benediktibk/home-automation/hardware/temperature-sensor/temperature-sensor.kicad_pcb

## KiCad design hardware/temperature-sensor/temperature-sensor.kicad_pcb (2025-07-15)

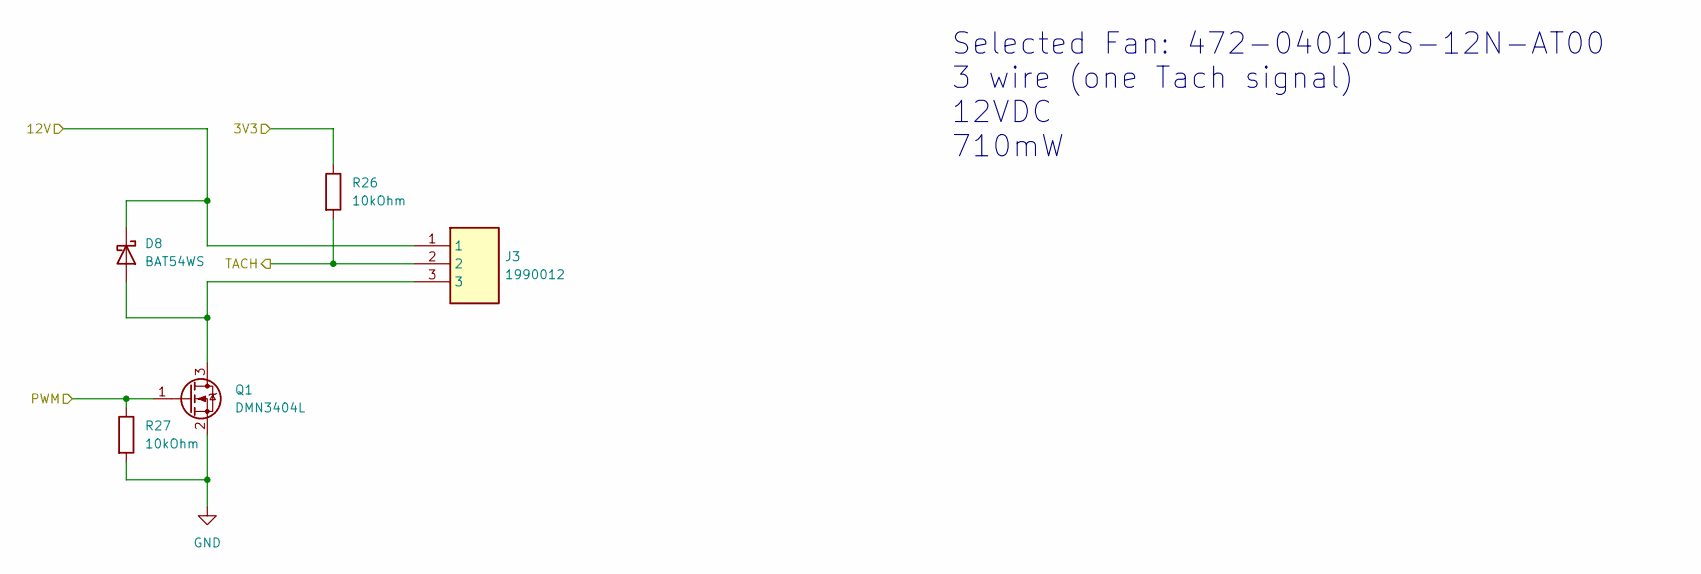
[picture p1: schematic fan.kicad_sch]

Parts:
D8: BAT54WS; D_SOD-323; Mouser Part Number 637-BAT54WS
J3: 1990012; Mouser Part Number 651-1990012
Q1: DMN3404L; SOT-23; Mouser Part Number 621-DMN3404L-7
R26, R27: 10kOhm; R_0603_1608Metric_Pad0.98x0.95mm_HandSolder; Mouser Part Number 652-CR0603FX-1002ELF

Connections:
/3V3: R26.1; also elsewhere on the board
/12V: D8.1 (K), J3.1; also elsewhere on the board
/Fan/PWM: Q1.1 (G), R27.1; also elsewhere on the board
/Fan/TACH: J3.2, R26.2; also elsewhere on the board
GND: Q1.2 (S), R27.2; also elsewhere on the board
unnamed: D8.2 (A), J3.3, Q1.3 (D)

Notes on the sheet:
Selected Fan: 472-04010SS-12N-AT00 3 wire (one Tach signal) 12VDC 710mW

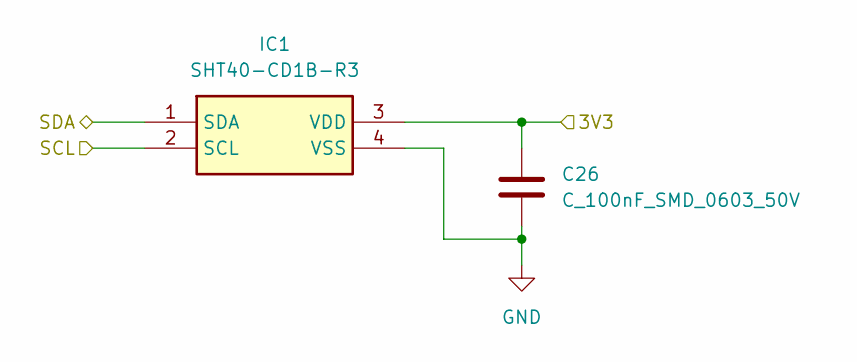
[picture p2: schematic measurement.kicad_sch]

Parts:
C26: C_100nF_SMD_0603_50V; C_0603_1608Metric_Pad1.08x0.95mm_HandSolder; Mouser Part Number 581-KGM15BR71H104KM
IC1: SHT40-CD1B-R3; SHT40CD1BR3; Mouser Part Number 403-SHT40-CD1B-R3

Connections:
/3V3: C26.1, IC1.3 (VDD); also elsewhere on the board
/MCU/SCL: IC1.2 (SCL); also elsewhere on the board
/MCU/SDA: IC1.1 (SDA); also elsewhere on the board
GND: C26.2, IC1.4 (VSS); also elsewhere on the board

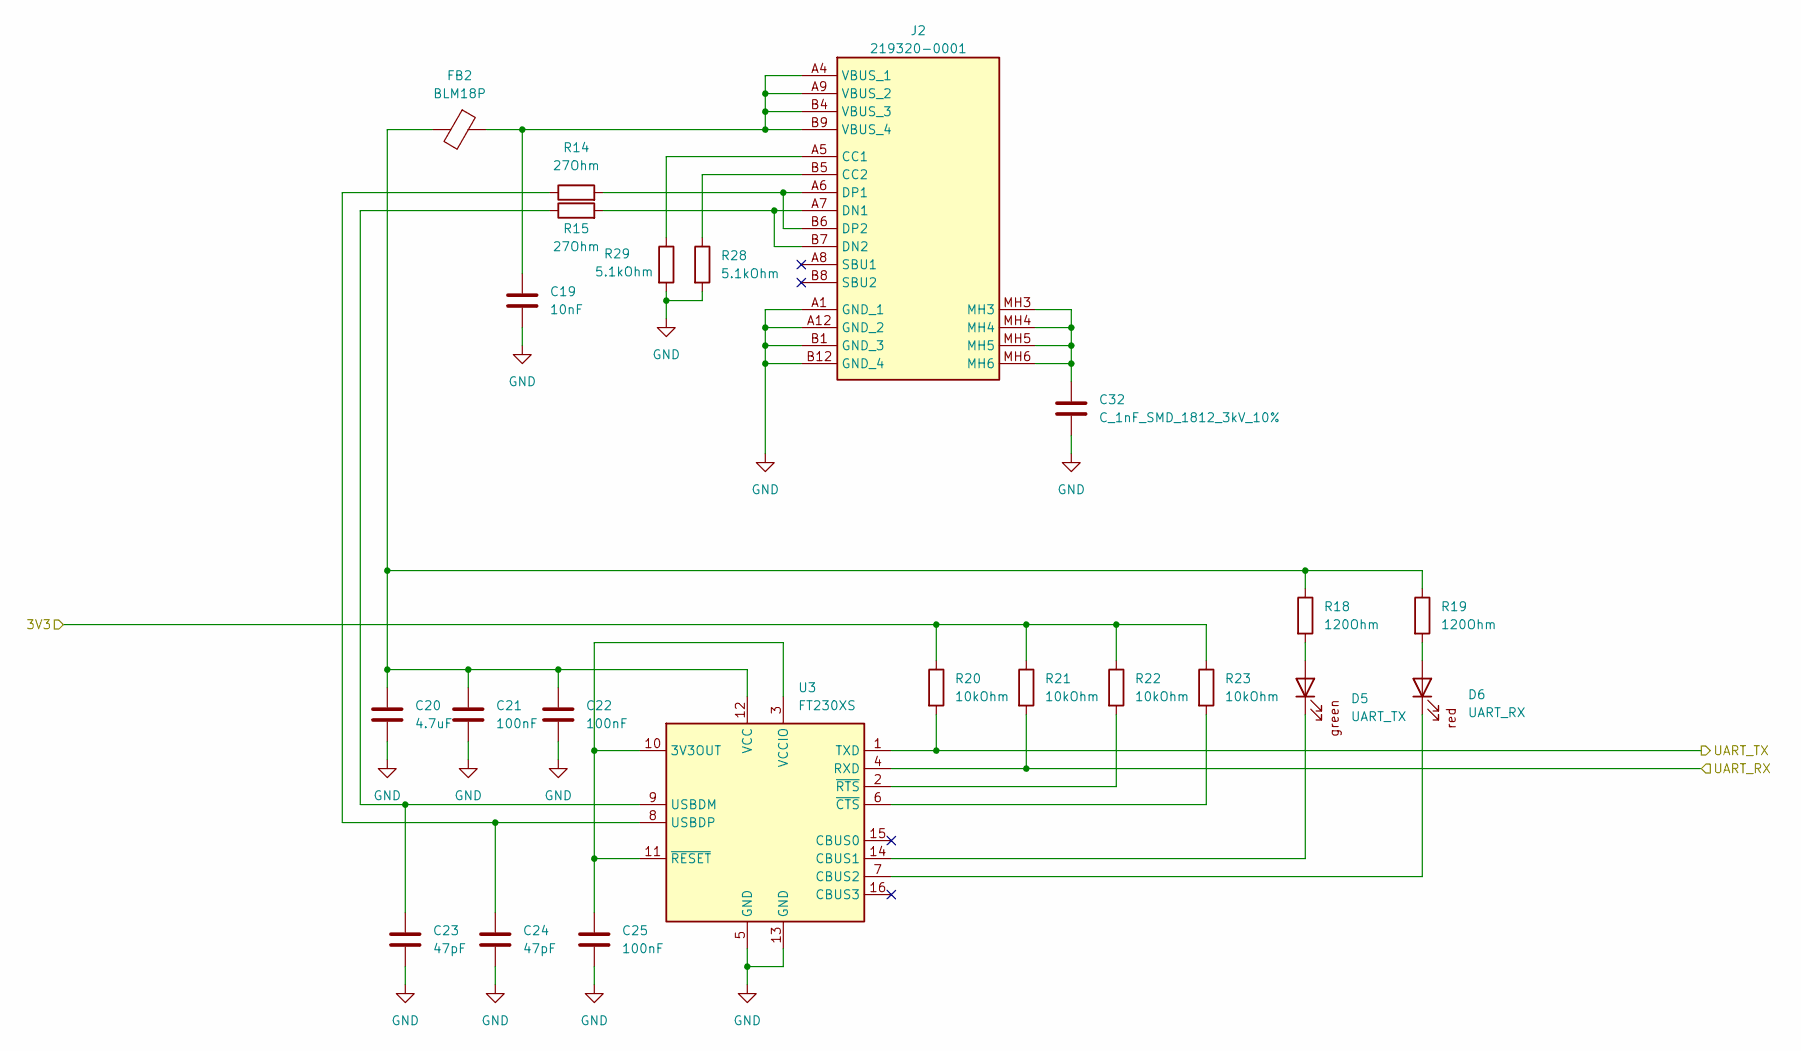
[picture p3: schematic usb.kicad_sch]

Parts:
C19: 10nF; C_0603_1608Metric_Pad1.08x0.95mm_HandSolder; Mouser Part Number 80-C0603C103M5R3121
C20: 4.7uF; C_0805_2012Metric_Pad1.18x1.45mm_HandSolder; Mouser Part Number 187-CL21A475KBQNNNE
C21, C22, C25: 100nF; C_0603_1608Metric_Pad1.08x0.95mm_HandSolder; Mouser Part Number 581-KGM15BR71H104KM
C23, C24: 47pF; C_0603_1608Metric_Pad1.08x0.95mm_HandSolder; Mouser Part Number 791-0603N470J101CT
C32: C_1nF_SMD_1812_3kV_10%; C_0603_1608Metric_Pad1.08x0.95mm_HandSolder; Mouser Part Number 791-1812B102K302CT
D5: UART_TX; D_0603_1608Metric_Pad1.05x0.95mm_HandSolder; Mouser Part Number 604-AP1608SGC
D6: UART_RX; D_0603_1608Metric_Pad1.05x0.95mm_HandSolder; Mouser Part Number 859-LTST-C190KDKT10A
FB2: BLM18P; R_0603_1608Metric_Pad0.98x0.95mm_HandSolder; Mouser Part Number 81-BLM11P300S
J2: 219320-0001; 2193200001; Mouser Part Number 538-219320-0001
R14, R15: 27Ohm; R_0603_1608Metric_Pad0.98x0.95mm_HandSolder; Mouser Part Number 603-RC0603FR-0727RL
R18, R19: 120Ohm; R_0603_1608Metric_Pad0.98x0.95mm_HandSolder; Mouser Part Number 603-RC0603FR-07120RL
R20, R21, R22, R23: 10kOhm; R_0603_1608Metric_Pad0.98x0.95mm_HandSolder; Mouser Part Number 652-CR0603FX-1002ELF
R28, R29: 5.1kOhm; R_0603_1608Metric_Pad0.98x0.95mm_HandSolder; Mouser Part Number 303-0603SAF5101T5E
U3: FT230XS; SSOP-16_3.9x4.9mm_P0.635mm; Mouser Part Number 895-FT230XS-R

Connections:
/3V3: R20.1, R21.1, R22.1, R23.1; also elsewhere on the board
/MCU/UART_RX: R20.2, U3.1 (TXD); also elsewhere on the board
/MCU/UART_TX: R21.2, U3.4 (RXD); also elsewhere on the board
GND: C19.2, C20.2, C21.2, C22.2, C23.2, C24.2, C25.2, C32.2, J2.A1 (GND_1), J2.A12 (GND_2), J2.B1 (GND_3), J2.B12 (GND_4), R28.2, R29.2, U3.5 (GND), U3.13 (GND); also elsewhere on the board
unnamed: C32.1, J2.MH3, J2.MH4, J2.MH5, J2.MH6
unnamed: D5.2 (A), R18.2
unnamed: D5.1 (K), U3.14 (CBUS1)
unnamed: D6.2 (A), R19.2
unnamed: D6.1 (K), U3.7 (CBUS2)
unnamed: J2.A5 (CC1), R29.1
unnamed: J2.B5 (CC2), R28.1
unnamed: J2.A7 (DN1), J2.B7 (DN2), R15.2
unnamed: J2.A6 (DP1), J2.B6 (DP2), R14.2
unnamed: C19.1, FB2.1, J2.A4 (VBUS_1), J2.A9 (VBUS_2), J2.B4 (VBUS_3), J2.B9 (VBUS_4)
unnamed: C25.1, U3.3 (VCCIO), U3.10 (3V3OUT), U3.11 (~RESET)
unnamed: C23.1, R15.1, U3.9 (USBDM)
unnamed: C24.1, R14.1, U3.8 (USBDP)
unnamed: C20.1, C21.1, C22.1, FB2.2, R18.1, R19.1, U3.12 (VCC)
unnamed: R23.2, U3.6 (~CTS)
unnamed: R22.2, U3.2 (~RTS)

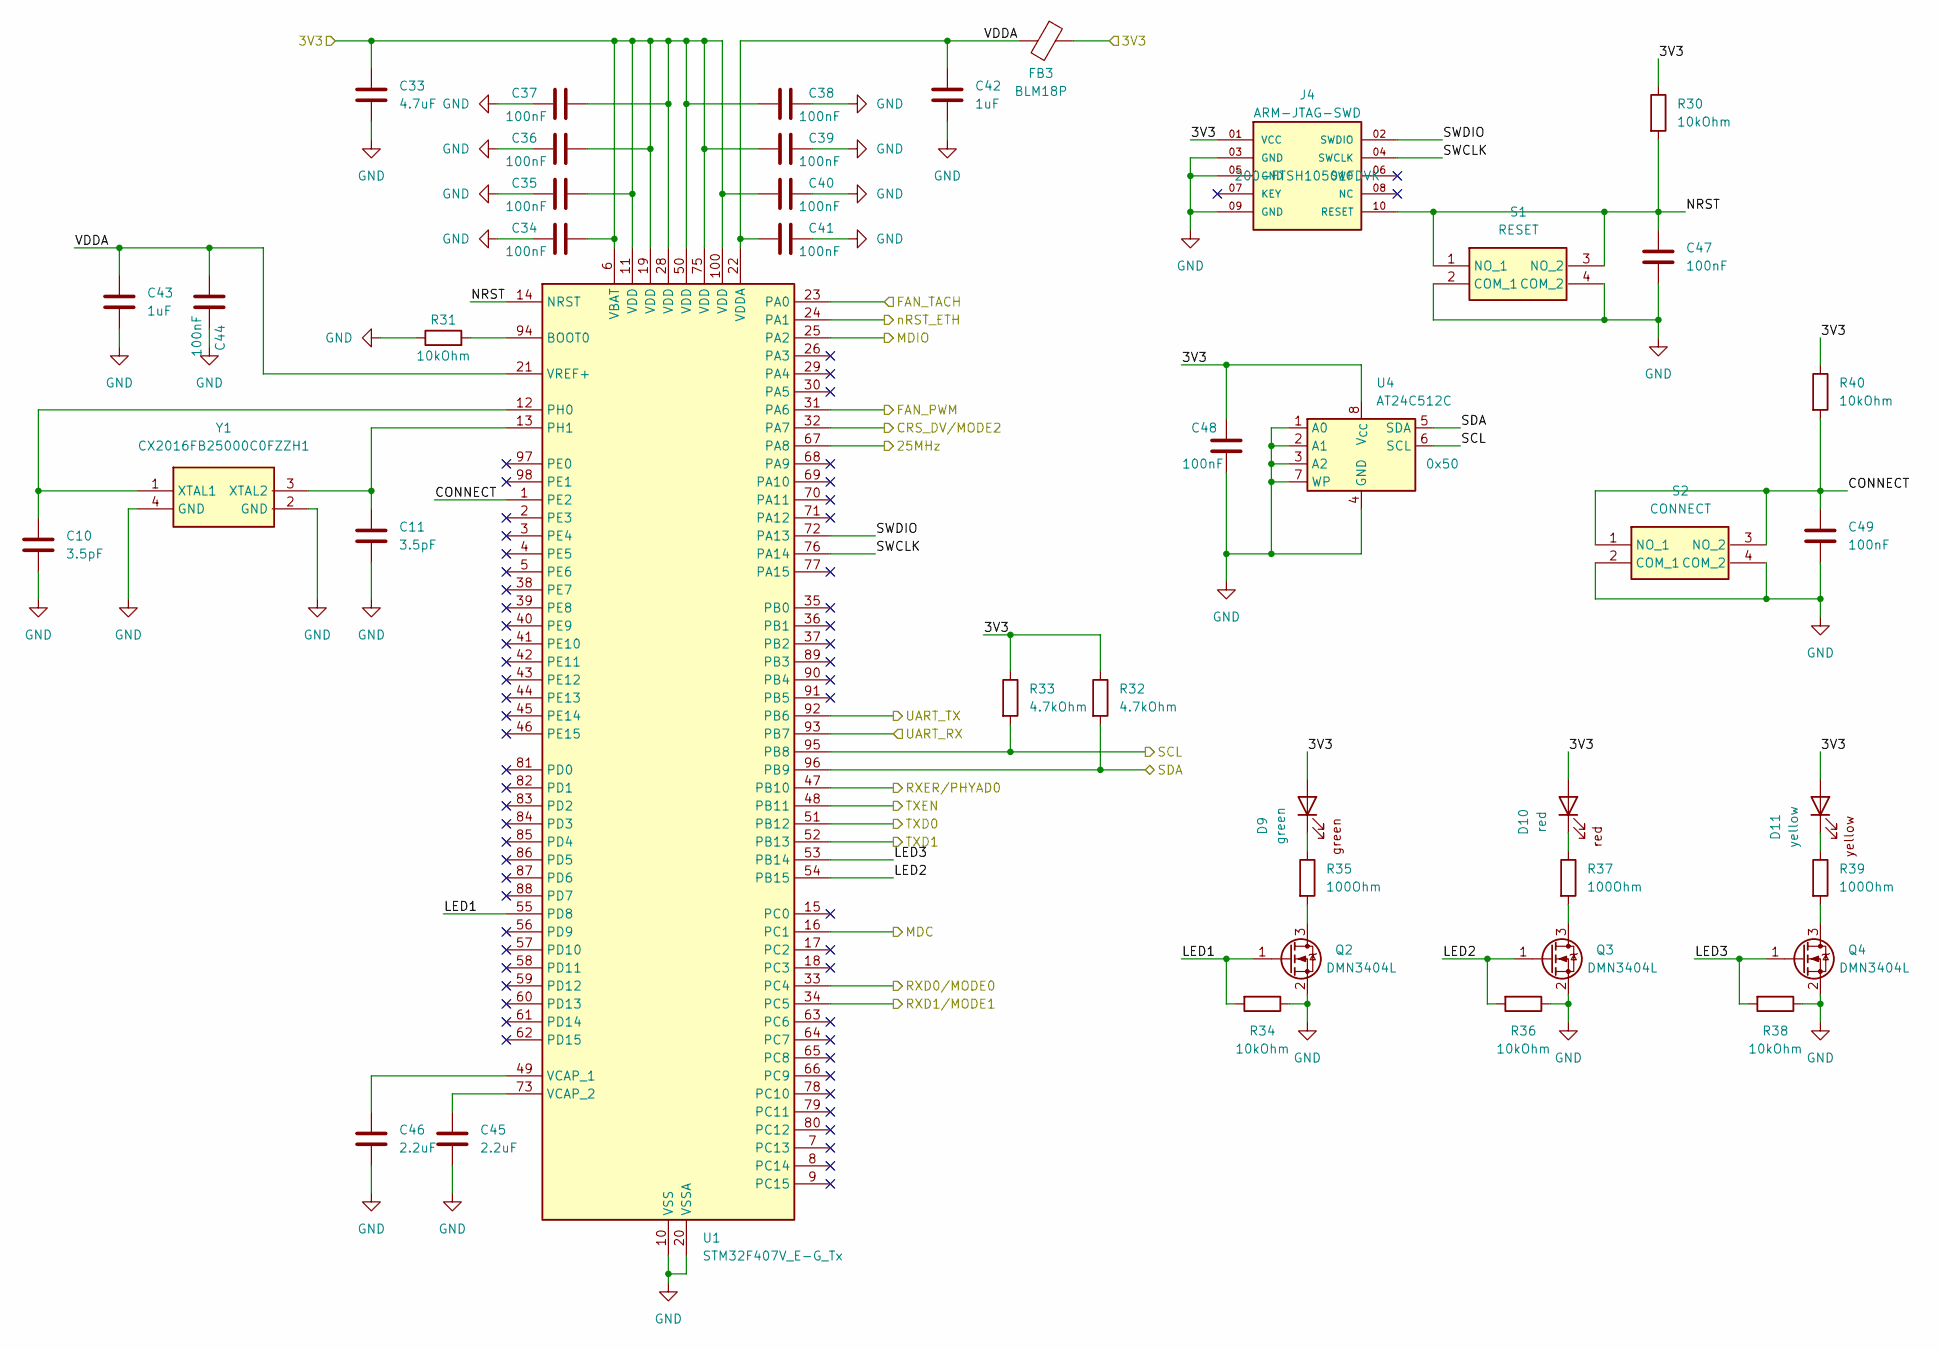
[picture p4: schematic MCU.kicad_sch]

Parts:
C10, C11: 3.5pF; C_0603_1608Metric_Pad1.08x0.95mm_HandSolder; Mouser Part Number 80-CBR06C359B5GAC
C33: 4.7uF; C_0805_2012Metric_Pad1.18x1.45mm_HandSolder; Mouser Part Number 187-CL21A475KBQNNNE
C34, C35, C36, C37, C38, C39, C40, C41, C44, C47, C48, C49: 100nF; C_0603_1608Metric_Pad1.08x0.95mm_HandSolder; Mouser Part Number 581-KGM15BR71H104KM
C42, C43: 1uF; C_0603_1608Metric_Pad1.08x0.95mm_HandSolder; Mouser Part Number 963-UMK107BJ105KA-T
C45, C46: 2.2uF; C_0603_1608Metric_Pad1.08x0.95mm_HandSolder; Mouser Part Number 187-CL10A225KP8NNND
D9: green; D_0603_1608Metric_Pad1.05x0.95mm_HandSolder; Mouser Part Number 604-AP1608SGC
D10: red; D_0603_1608Metric_Pad1.05x0.95mm_HandSolder; Mouser Part Number 859-LTST-C190KDKT10A
D11: yellow; D_0603_1608Metric_Pad1.05x0.95mm_HandSolder; Mouser Part Number 604-APG1608SYKC/T
FB3: BLM18P; R_0603_1608Metric_Pad0.98x0.95mm_HandSolder; Mouser Part Number 81-BLM11P300S
J4: ARM-JTAG-SWD; SAMTEC_FTSH-105-01-F-DV-P-TR; Mouser Part Number 200-FTSH10501FDVK
Q2, Q3, Q4: DMN3404L; SOT-23; Mouser Part Number 621-DMN3404L-7
R30, R31, R34, R36, R38, R40: 10kOhm; R_0603_1608Metric_Pad0.98x0.95mm_HandSolder; Mouser Part Number 652-CR0603FX-1002ELF
R32, R33: 4.7kOhm; R_0603_1608Metric_Pad0.98x0.95mm_HandSolder; Mouser Part Number 652-CR0603FX-4701ELF
R35, R37, R39: 100Ohm; R_0603_1608Metric_Pad0.98x0.95mm_HandSolder; Mouser Part Number 279-CRGH0603F100R
S1: RESET; TS046673BK100SMT; Mouser Part Number 179-TS046673BK100SMT
S2: CONNECT; TS046673BK100SMT; Mouser Part Number 179-TS046673BK100SMT
U1: STM32F407V_E-G_Tx; LQFP-100_14x14mm_P0.5mm; Mouser Part Number 511-STM32F407VGT6
U4: AT24C512C; SOIC127P600X175-8N; Mouser Part Number 556-AT24C512C-SSHM-T
Y1: CX2016FB25000C0FZZH1; Mouser Part Number 581-CX2016FB25C0FZZH

Connections:
/3V3: C33.1, C34.1, C35.1, C36.1, C37.1, C38.1, C39.1, C40.1, C48.1, D9.2 (A), D10.2 (A), D11.2 (A), FB3.1, J4.01 (VCC), R30.1, R32.1, R33.1, R40.1, U1.6 (VBAT), U1.11 (VDD), U1.19 (VDD), U1.28 (VDD), U1.50 (VDD), U1.75 (VDD), U1.100 (VDD), U4.8 (V_{CC}); also elsewhere on the board
/Ethernet/25MHz: U1.67 (PA8); also elsewhere on the board
/Ethernet/CRS_DV/MODE2: U1.32 (PA7); also elsewhere on the board
/Ethernet/MDC: U1.16 (PC1); also elsewhere on the board
/Ethernet/MDIO: U1.25 (PA2); also elsewhere on the board
/Ethernet/RXD0/MODE0: U1.33 (PC4); also elsewhere on the board
/Ethernet/RXD1/MODE1: U1.34 (PC5); also elsewhere on the board
/Ethernet/RXER/PHYAD0: U1.47 (PB10); also elsewhere on the board
/Ethernet/TXD0: U1.51 (PB12); also elsewhere on the board
/Ethernet/TXD1: U1.52 (PB13); also elsewhere on the board
/Ethernet/TXEN: U1.48 (PB11); also elsewhere on the board
/Ethernet/nRST: U1.24 (PA1); also elsewhere on the board
/Fan/PWM: U1.31 (PA6); also elsewhere on the board
/Fan/TACH: U1.23 (PA0); also elsewhere on the board
/MCU/CONNECT: C49.1, R40.2, S2.1 (NO_1), S2.3 (NO_2), U1.1 (PE2)
/MCU/LED1: Q2.1 (G), R34.2, U1.55 (PD8)
/MCU/LED2: Q3.1 (G), R36.2, U1.54 (PB15)
/MCU/LED3: Q4.1 (G), R38.2, U1.53 (PB14)
/MCU/NRST: C47.1, J4.10 (RESET), R30.2, S1.1 (NO_1), S1.3 (NO_2), U1.14 (NRST)
/MCU/SCL: R33.2, U1.95 (PB8), U4.6 (SCL); also elsewhere on the board
/MCU/SDA: R32.2, U1.96 (PB9), U4.5 (SDA); also elsewhere on the board
/MCU/SWCLK: J4.04 (SWCLK), U1.76 (PA14)
/MCU/SWDIO: J4.02 (SWDIO), U1.72 (PA13)
/MCU/UART_RX: U1.93 (PB7); also elsewhere on the board
/MCU/UART_TX: U1.92 (PB6); also elsewhere on the board
/MCU/VDDA: C41.1, C42.1, C43.1, C44.1, FB3.2, U1.21 (VREF+), U1.22 (VDDA)
GND: C10.2, C11.2, C33.2, C34.2, C35.2, C36.2, C37.2, C38.2, C39.2, C40.2, C41.2, C42.2, C43.2, C44.2, C45.2, C46.2, C47.2, C48.2, C49.2, J4.03 (GND), J4.05 (GND), J4.09 (GND), Q2.2 (S), Q3.2 (S), Q4.2 (S), R31.1, R34.1, R36.1, R38.1, S1.2 (COM_1), S1.4 (COM_2), S2.2 (COM_1), S2.4 (COM_2), U1.10 (VSS), U1.20 (VSSA), U1.27 (VSS), U1.74 (VSS), U1.99 (VSS), U4.1 (A0), U4.2 (A1), U4.3 (A2), U4.4 (GND), U4.7 (WP), Y1.2 (GND), Y1.4 (GND); also elsewhere on the board
unnamed: D9.1 (K), R35.1
unnamed: D10.1 (K), R37.1
unnamed: D11.1 (K), R39.1
unnamed: Q2.3 (D), R35.2
unnamed: Q3.3 (D), R37.2
unnamed: Q4.3 (D), R39.2
unnamed: R31.2, U1.94 (BOOT0)
unnamed: C10.1, U1.12 (PH0), Y1.1 (XTAL1)
unnamed: C11.1, U1.13 (PH1), Y1.3 (XTAL2)
unnamed: C46.1, U1.49 (VCAP_1)
unnamed: C45.1, U1.73 (VCAP_2)

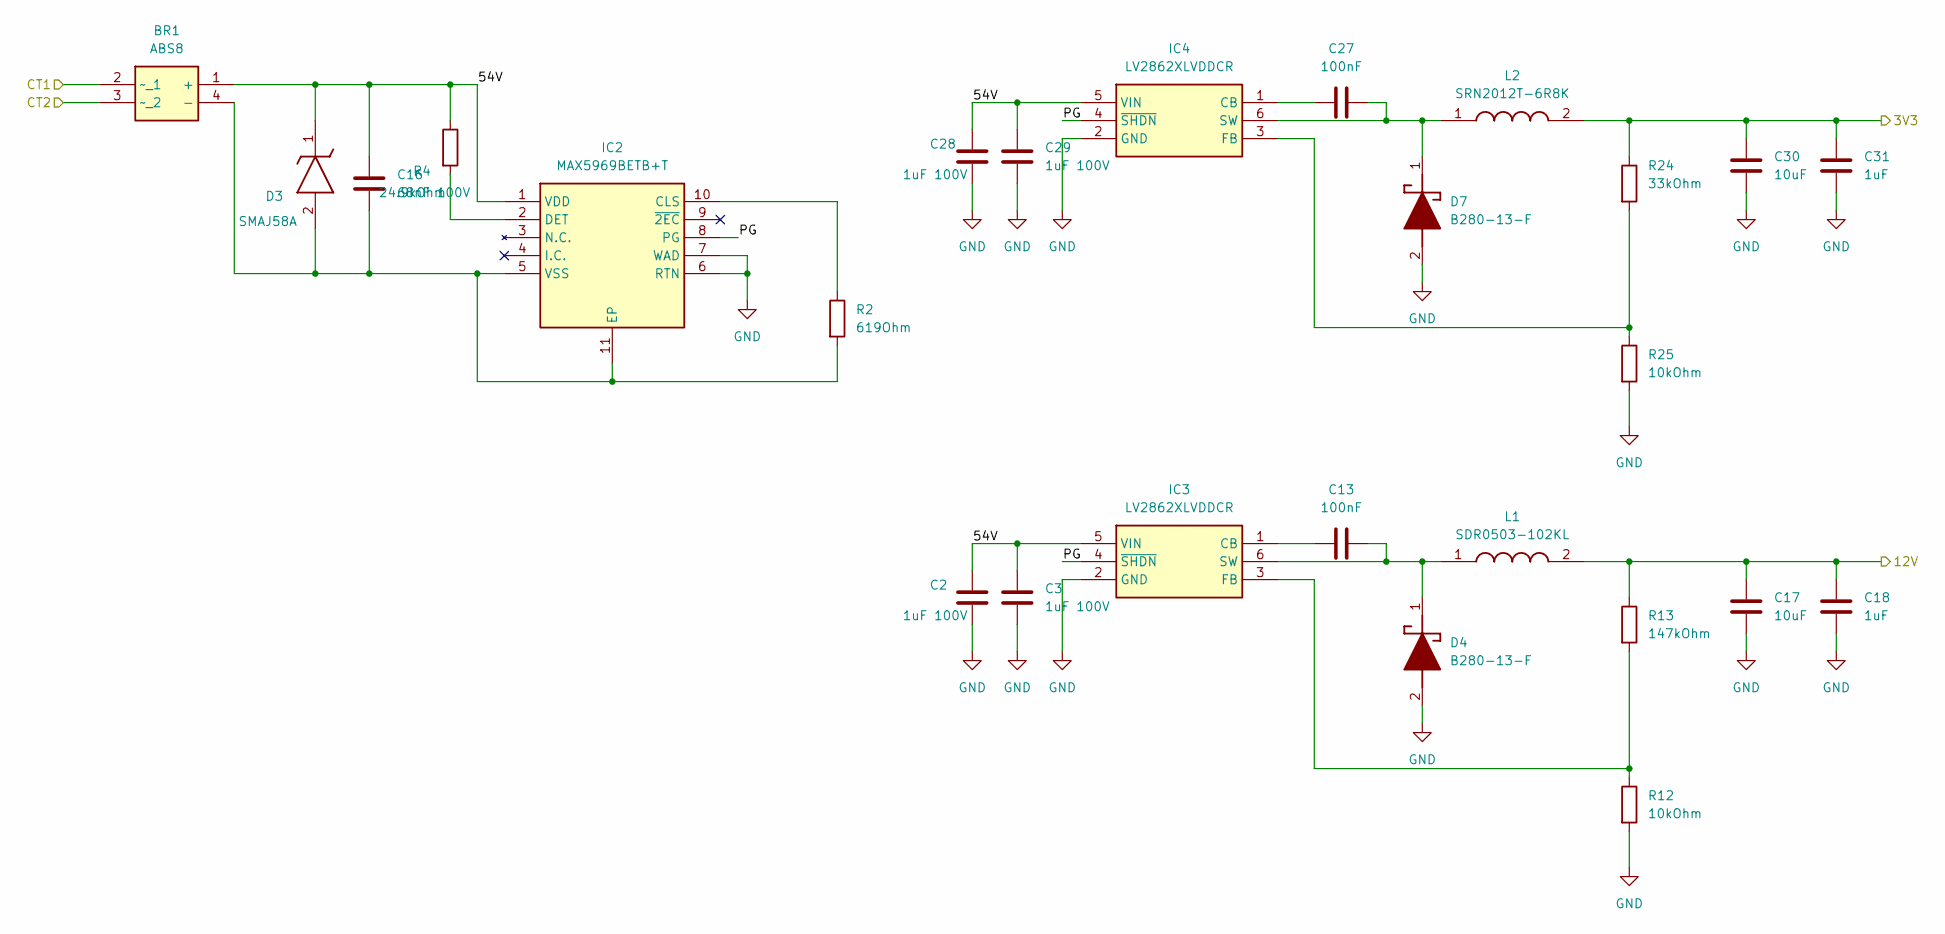
[picture p5: schematic power_over_ethernet.kicad_sch]

Parts:
BR1: ABS8; Mouser Part Number 637-ABS8
C2, C3, C28, C29: 1uF 100V; C_0603_1608Metric_Pad1.08x0.95mm_HandSolder; Mouser Part Number 810-C1608X7R2A105K08
C13, C27: 100nF; C_0603_1608Metric_Pad1.08x0.95mm_HandSolder; Mouser Part Number 581-KGM15BR71H104KM
C16: 68nF 100V; C_0603_1608Metric_Pad1.08x0.95mm_HandSolder; Mouser Part Number 791-0603B683K101CT
C17, C30: 10uF; C_1210_3225Metric_Pad1.33x2.70mm_HandSolder; Mouser Part Number 187-CL31A106MBHNNNE
C18, C31: 1uF; C_0603_1608Metric_Pad1.08x0.95mm_HandSolder; Mouser Part Number 963-UMK107BJ105KA-T
D3: SMAJ58A; DIOM5026X229N; Mouser Part Number 576-SMAJ58A
D4, D7: B280-13-F; DIOM5336X250N; Mouser Part Number 621-B280-13-F
IC2: MAX5969BETB+T; SON50P300X300X80-11N; Mouser Part Number 700-MAX5969BETB+T
IC3, IC4: LV2862XLVDDCR; SOT95P280X110-6N; Mouser Part Number 595-LV2862XLVDDCR
L1: SDR0503-102KL; SDR0503102KL; Mouser Part Number 652-SDR0503-102KL
L2: SRN2012T-6R8K; INDPM2012X120N; Mouser Part Number 652-SRN2012T-6R8K
R2: 619Ohm; R_0603_1608Metric_Pad0.98x0.95mm_HandSolder; Mouser Part Number 603-RT0603FRE07619RL
R4: 24.9kOhm; R_0603_1608Metric_Pad0.98x0.95mm_HandSolder; Mouser Part Number 594-MCT06030C2492FP5
R12, R25: 10kOhm; R_0603_1608Metric_Pad0.98x0.95mm_HandSolder; Mouser Part Number 652-CR0603FX-1002ELF
R13: 147kOhm; R_0603_1608Metric_Pad0.98x0.95mm_HandSolder; Mouser Part Number 594-MCT06030C1473FP5
R24: 33kOhm; R_0603_1608Metric_Pad0.98x0.95mm_HandSolder; Mouser Part Number 594-MCT06030C3302FP5

Connections:
/3V3: C30.1, C31.1, L2.2, R24.1; also elsewhere on the board
/12V: C17.1, C18.1, L1.2, R13.1; also elsewhere on the board
/Ethernet/CT1: BR1.2 (~_1); also elsewhere on the board
/Ethernet/CT2: BR1.3 (~_2); also elsewhere on the board
/Power over Ethernet/54V: BR1.1 (+), C2.1, C3.1, C16.1, C28.1, C29.1, D3.1 (K), IC2.1 (VDD), IC3.5 (VIN), IC4.5 (VIN), R4.1
/Power over Ethernet/PG: IC2.8 (PG), IC3.4 (~SHDN), IC4.4 (~SHDN)
GND: C2.2, C3.2, C17.2, C18.2, C28.2, C29.2, C30.2, C31.2, D4.2 (A), D7.2 (A), IC2.6 (RTN), IC2.7 (WAD), IC3.2 (GND), IC4.2 (GND), R12.2, R25.2; also elsewhere on the board
unnamed: BR1.4 (-), C16.2, D3.2 (A), IC2.5 (VSS), IC2.11 (EP), R2.2
unnamed: C13.1, D4.1 (K), IC3.6 (SW), L1.1
unnamed: C27.1, D7.1 (K), IC4.6 (SW), L2.1
unnamed: IC2.10 (CLS), R2.1
unnamed: IC2.2 (DET), R4.2
unnamed: C13.2, IC3.1 (CB)
unnamed: IC3.3 (FB), R12.1, R13.2
unnamed: C27.2, IC4.1 (CB)
unnamed: IC4.3 (FB), R24.2, R25.1

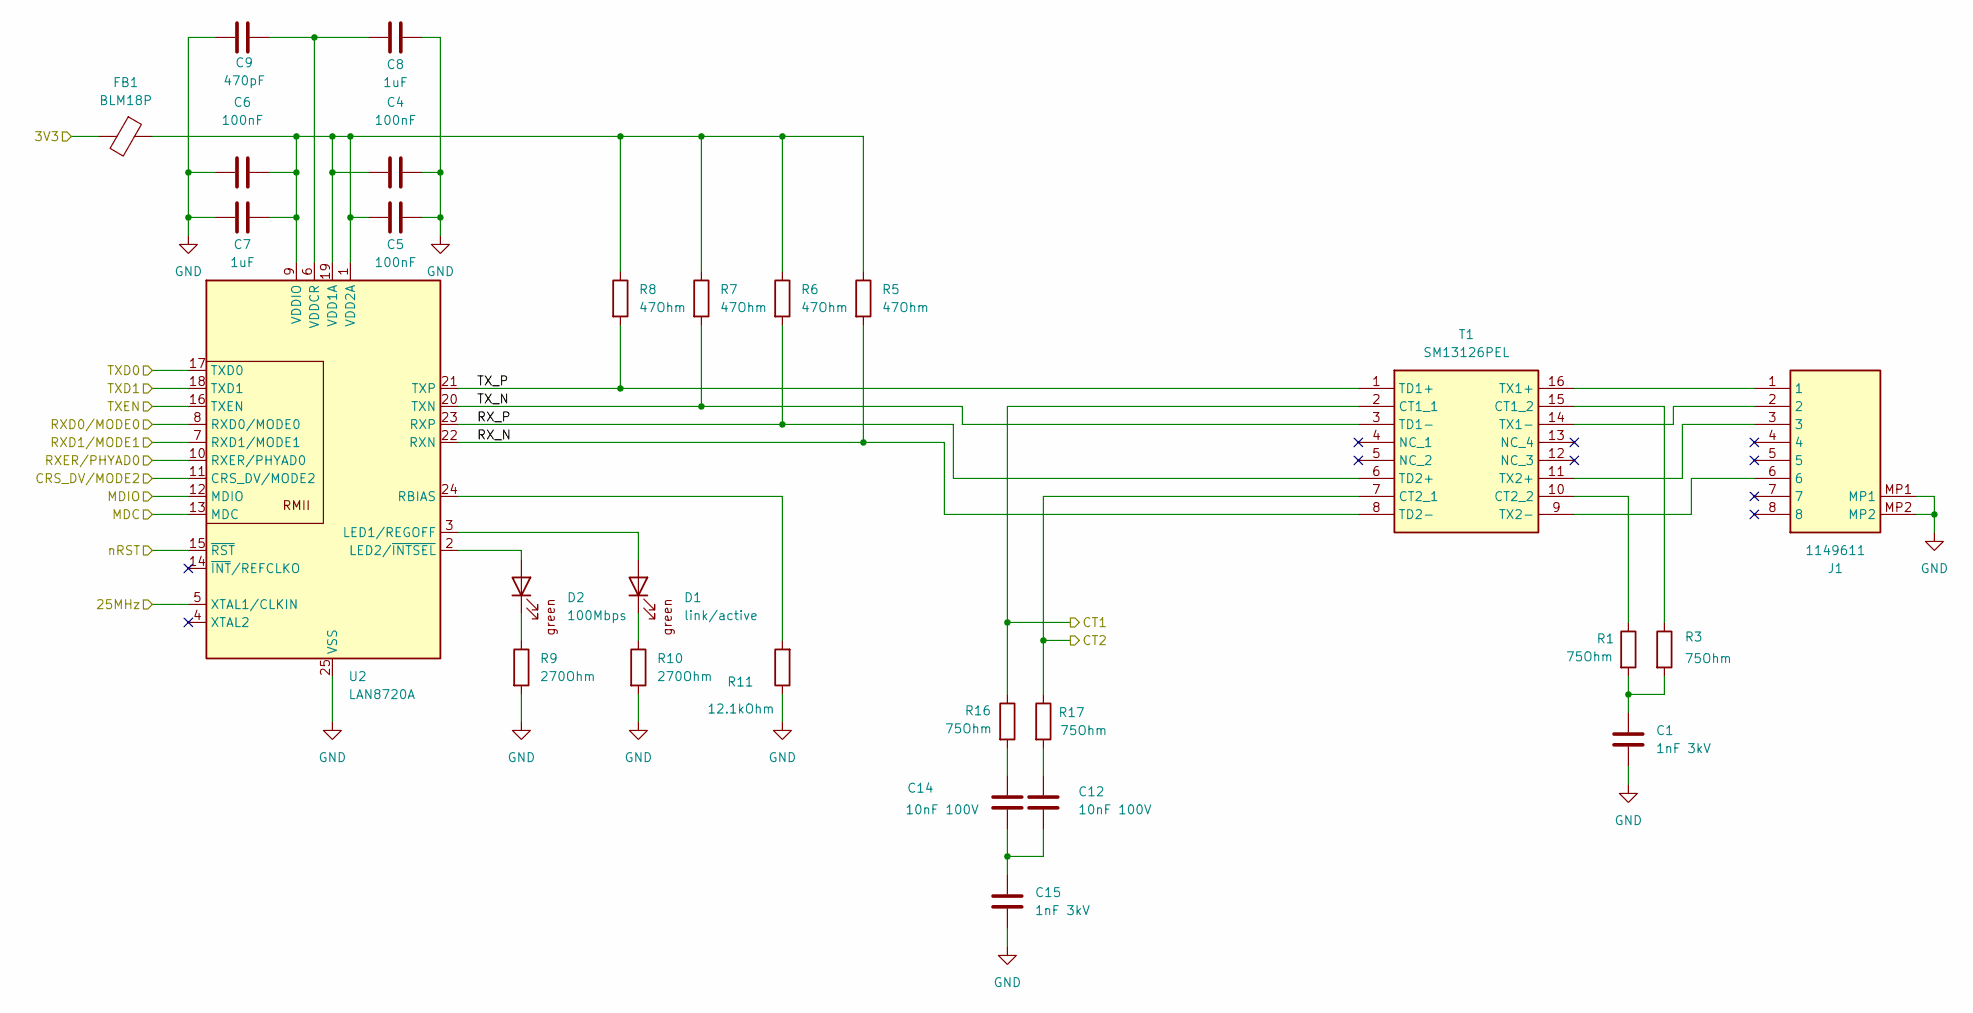
[picture p6: schematic Ethernet.kicad_sch]

Parts:
C1, C15: 1nF 3kV; C_0603_1608Metric_Pad1.08x0.95mm_HandSolder; Mouser Part Number 791-1812B102K302CT
C4, C5, C6: 100nF; C_0603_1608Metric_Pad1.08x0.95mm_HandSolder; Mouser Part Number 581-KGM15BR71H104KM
C7, C8: 1uF; C_0603_1608Metric_Pad1.08x0.95mm_HandSolder; Mouser Part Number 963-UMK107BJ105KA-T
C9: 470pF; C_0603_1608Metric_Pad1.08x0.95mm_HandSolder; Mouser Part Number 187-CL10C471JB81PNC
C12, C14: 10nF 100V; C_0603_1608Metric_Pad1.08x0.95mm_HandSolder; Mouser Part Number 581-06031C103K4T2A
D1: link/active; D_0603_1608Metric_Pad1.05x0.95mm_HandSolder; Mouser Part Number 604-AP1608SGC
D2: 100Mbps; D_0603_1608Metric_Pad1.05x0.95mm_HandSolder; Mouser Part Number 604-AP1608SGC
FB1: BLM18P; R_0603_1608Metric_Pad0.98x0.95mm_HandSolder; Mouser Part Number 81-BLM11P300S
J1: 1149611; Mouser Part Number 651-1149611
R1, R3, R16, R17: 75Ohm; R_0603_1608Metric_Pad0.98x0.95mm_HandSolder; Mouser Part Number 71-CRCW060375R0FKEAC
R5, R6, R7, R8: 47Ohm; R_0603_1608Metric_Pad0.98x0.95mm_HandSolder; Mouser Part Number 603-AC0603FR-1347RL
R9, R10: 270Ohm; R_0603_1608Metric_Pad0.98x0.95mm_HandSolder; Mouser Part Number 603-RE0603FRE07270RL
R11: 12.1kOhm; R_0603_1608Metric_Pad0.98x0.95mm_HandSolder; Mouser Part Number 603-RT0603FRE1012K1L
T1: SM13126PEL; Mouser Part Number 652-SM13126PEL
U2: LAN8720A; LAN8720A-CP-ABC; Mouser Part No 579-LAN8720ACPABC

Connections:
/3V3: FB1.2; also elsewhere on the board
/Ethernet/25MHz: U2.5 (XTAL1/CLKIN); also elsewhere on the board
/Ethernet/CRS_DV/MODE2: U2.11 (CRS_DV/MODE2); also elsewhere on the board
/Ethernet/CT1: R16.1, T1.2 (CT1_1); also elsewhere on the board
/Ethernet/CT2: R17.1, T1.7 (CT2_1); also elsewhere on the board
/Ethernet/MDC: U2.13 (MDC); also elsewhere on the board
/Ethernet/MDIO: U2.12 (MDIO); also elsewhere on the board
/Ethernet/RXD0/MODE0: U2.8 (RXD0/MODE0); also elsewhere on the board
/Ethernet/RXD1/MODE1: U2.7 (RXD1/MODE1); also elsewhere on the board
/Ethernet/RXER/PHYAD0: U2.10 (RXER/PHYAD0); also elsewhere on the board
/Ethernet/RX_N: R5.2, T1.8 (TD2-), U2.22 (RXN)
/Ethernet/RX_P: R6.2, T1.6 (TD2+), U2.23 (RXP)
/Ethernet/TXD0: U2.17 (TXD0); also elsewhere on the board
/Ethernet/TXD1: U2.18 (TXD1); also elsewhere on the board
/Ethernet/TXEN: U2.16 (TXEN); also elsewhere on the board
/Ethernet/TX_N: R7.2, T1.3 (TD1-), U2.20 (TXN)
/Ethernet/TX_P: R8.2, T1.1 (TD1+), U2.21 (TXP)
/Ethernet/nRST: U2.15 (~RST); also elsewhere on the board
GND: C1.2, C4.1, C5.2, C6.2, C7.2, C8.1, C9.2, C15.2, J1.MP1, J1.MP2, R9.2, R10.2, R11.1, U2.25 (VSS); also elsewhere on the board
unnamed: C1.1, R1.2, R3.2
unnamed: C12.1, R17.2
unnamed: C12.2, C14.2, C15.1
unnamed: C14.1, R16.2
unnamed: D1.2 (A), U2.3 (LED1/REGOFF)
unnamed: D1.1 (K), R10.1
unnamed: D2.2 (A), U2.2 (LED2/~INTSEL)
unnamed: D2.1 (K), R9.1
unnamed: R3.1, T1.15 (CT1_2)
unnamed: R1.1, T1.10 (CT2_2)
unnamed: J1.1, T1.16 (TX1+)
unnamed: J1.2, T1.14 (TX1-)
unnamed: J1.3, T1.11 (TX2+)
unnamed: J1.6, T1.9 (TX2-)
unnamed: R11.2, U2.24 (RBIAS)
unnamed: C4.2, C5.1, C6.1, C7.1, FB1.1, R5.1, R6.1, R7.1, R8.1, U2.1 (VDD2A), U2.9 (VDDIO), U2.19 (VDD1A)
unnamed: C8.2, C9.1, U2.6 (VDDCR)

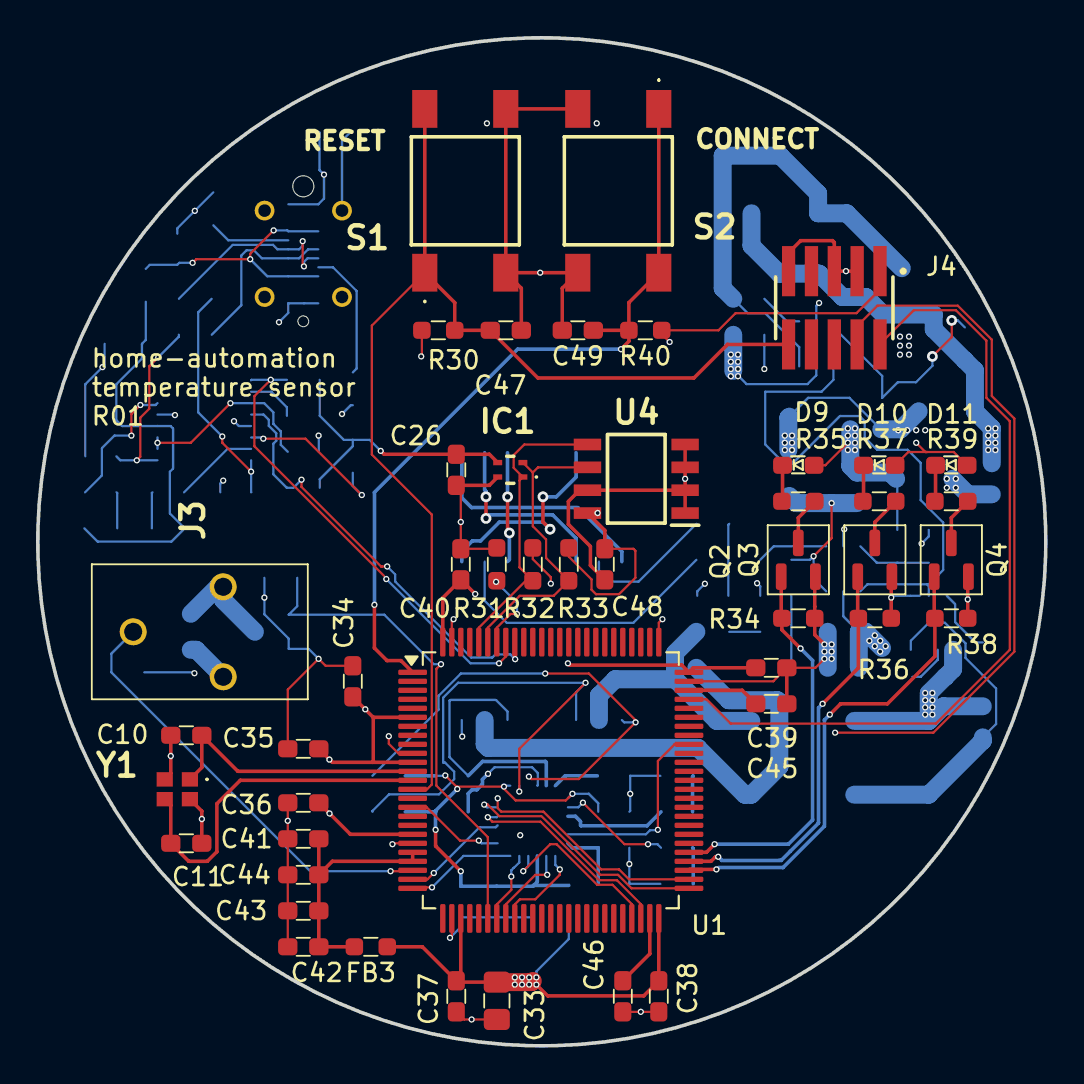
[picture p7: board temperature-sensor.kicad_pcb from above]

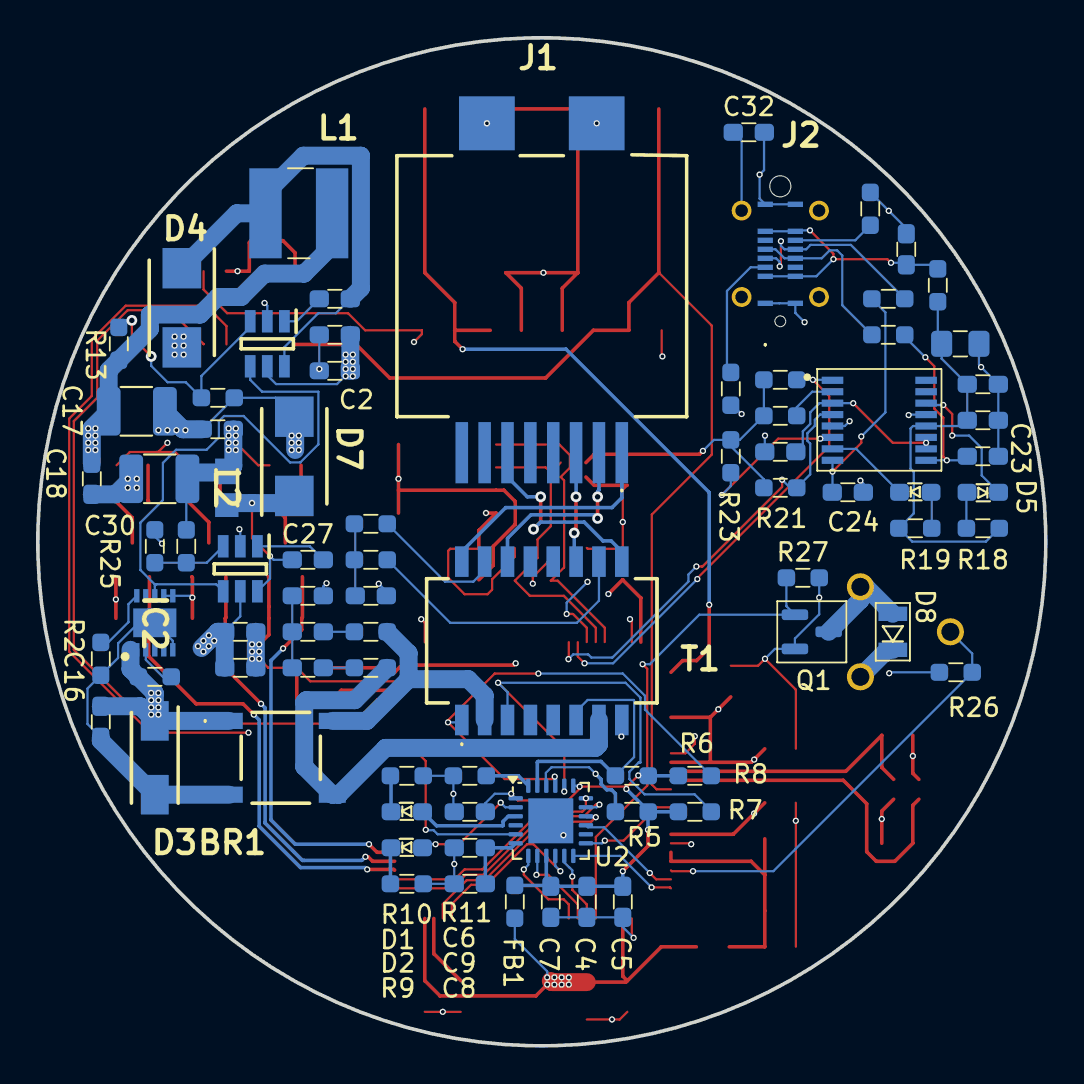
[picture p8: board temperature-sensor.kicad_pcb from below]

Board: 4 copper layers, 56.0 x 56.0 mm, 126 parts (80 on the bottom side), 90 nets.
