benediktibk/home-automation/(commit log)

2024-12-29 add empty KiCAD project for temperature sensor
    [temperature-sensor.kicad_pcb, temperature-sensor.kicad_sch]
2024-12-29 add basic required parts
    [Ethernet.kicad_sch, MCU.kicad_sch, temperature-sensor.kicad_pcb, temperature-sensor.kicad_sch, untitled.kicad_sch]
2025-03-16 add components for temperature sensor
    [Ethernet.kicad_sch, MCU.kicad_sch, temperature-sensor.kicad_pcb]
2025-07-07 extend schematic of ethernet
    [Ethernet.kicad_sch, MCU.kicad_sch, fan.kicad_sch, measurement.kicad_sch, temperature-sensor.kicad_pcb, temperature-sensor.kicad_sch]
2025-07-08 add quartz
    [Ethernet.kicad_sch, MCU.kicad_sch, temperature-sensor.kicad_pcb]
2025-07-09 replace ethernet transformer
    [Ethernet.kicad_sch]
2025-07-09 update PCB from schematic
    [temperature-sensor.kicad_pcb]
2025-07-09 add bridge rectifier to PoE
    [Ethernet.kicad_sch]
2025-07-11 replace lan transformer with a 2 channel version
    [Ethernet.kicad_sch, power_over_ethernet.kicad_sch, temperature-sensor.kicad_sch]
2025-07-11 work on temperature sensor
    [Ethernet.kicad_sch, MCU.kicad_sch, measurement.kicad_sch, power_over_ethernet.kicad_sch, temperature-sensor.kicad_pcb, temperature-sensor.kicad_sch, usb.kicad_sch]
2025-07-11 replace USB micro with USB c
    [temperature-sensor.kicad_pcb, usb.kicad_sch]
2025-07-14 add connection to FAN PWM and TACH
    [MCU.kicad_sch, temperature-sensor.kicad_sch]
2025-07-14 start with layout of ethernet and PoE
    [temperature-sensor.kicad_pcb]
2025-07-14 place components of PoE
    [MCU.kicad_sch, temperature-sensor.kicad_pcb]
2025-07-14 place USB footprints
    [temperature-sensor.kicad_pcb]
2025-07-15 place temperature sensor footprint
    [temperature-sensor.kicad_pcb]
2025-07-15 finish placement
    [MCU.kicad_sch, temperature-sensor.kicad_pcb]
2025-07-15 improve placement of temperature sensor
    [temperature-sensor.kicad_pcb]
2025-07-15 define layers for routing
    [temperature-sensor.kicad_pcb]
2025-07-15 start with routing
    [temperature-sensor.kicad_pcb]
2025-07-15 prepare generation of fabrication files
    [temperature-sensor.kicad_pcb]
2025-07-15 route temperature sensor
    [temperature-sensor.kicad_pcb]
2025-07-15 update symbols from library
    [Ethernet.kicad_sch, MCU.kicad_sch]
2025-07-15 add missing routes
    [MCU.kicad_sch, temperature-sensor.kicad_pcb]
2025-07-15 fix DRC errors
    [temperature-sensor.kicad_pcb]
2025-07-15 fix silkscreen
    [MCU.kicad_sch, temperature-sensor.kicad_pcb]
2025-07-15 create fabrication files for temperature sensor R01
    [temperature-sensor-r01-bom.csv]
